cbm-instructions/aehaeh/(commit log)

2023-11-29 database framework
2023-12-06 2end wheel
2023-12-06 MQTT in Threads & fix in javascript
    [test.py]
2023-12-06 JSON parser not working right now
    [test.py]
2023-12-09 backend Client sends current system time to other clients each minute via mqtt + dummy client
2023-12-09 Thread doesnt start twice now
2023-12-14 adapted javascript to make it work with buttons and knob
2023-12-15 fix: socket for back button
    [test.py]
2023-12-15 Added socket functions for buttons
2023-12-17 Die Reservierung wird nun nach Bearbeitung in der Ansicht dargestellt und kann abgeschlossen werden.
2023-12-17 javascript Button-Socket-Key's angepasst.
2023-12-18 Buttons and knob work
2024-01-14 fixed issue with reservations
    [dummy_client.py, test.py]
2024-01-15 buttons working again
2024-01-28 feat: added ESP32 Code
